FrancescaFr/MEMA/Pictures/DilutionTestChamber.JPG

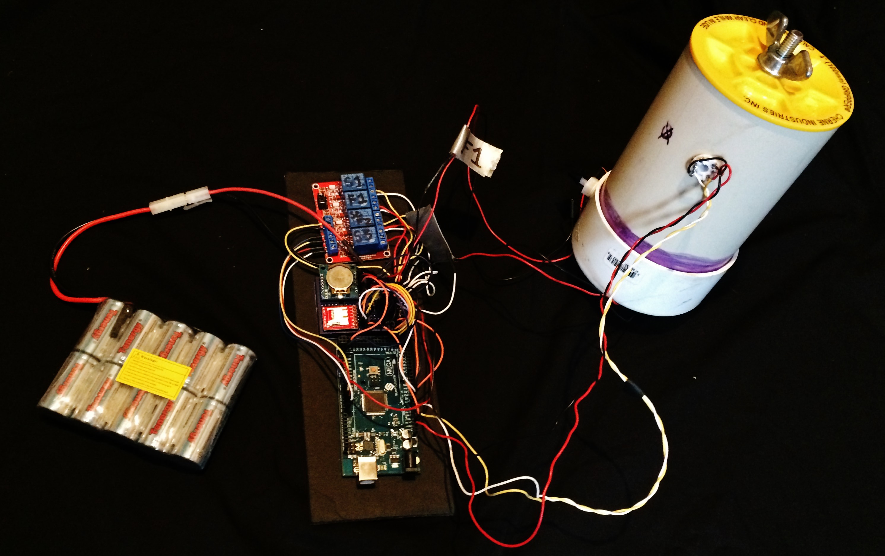
Pictures/DilutionTestChamber.JPG
