FrancescaFr/MEMA/Pictures/MEMA_V1.1_FieldTest.png

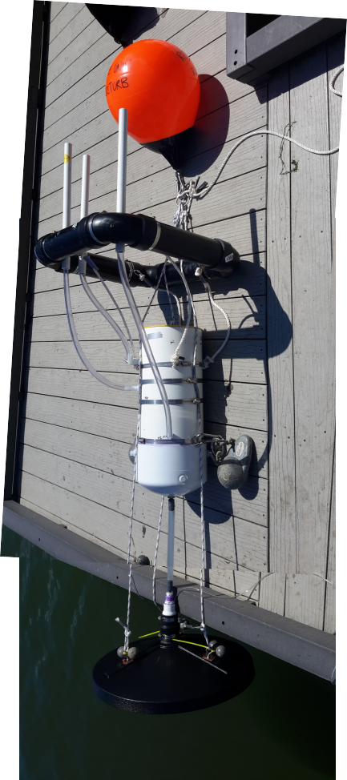
Pictures/MEMA_V1.1_FieldTest.png
