FrancescaFr/MEMA/Original_Project_Proposal.pdf

Low-cost, methane sensor for in-situ ebullition measurement

Context:
WSU Bio-geochemistry lab's methane ebullition study- an attempt to characterize methane emissions from Lacamas Reservoir, identifying spatial and temporal trends in methane ebullition and associated environmental and management factors.

Current data collection methods:
- Weather and management data -- provided by external sources (weather stations, reservoir management).
- Temperature and oxygen profiles – in-person, semi-weekly, water-column measurements.
- Dissolved methane, oxygen, and other nutrients – samples taken in conjunction with other water-column measurements and processed in-lab at a later date.
- Methane ebullition – array of ~15 methane traps distributed throughout Lacamas (active and passive) which collect bubbling methane for later extraction and in-lab processing.

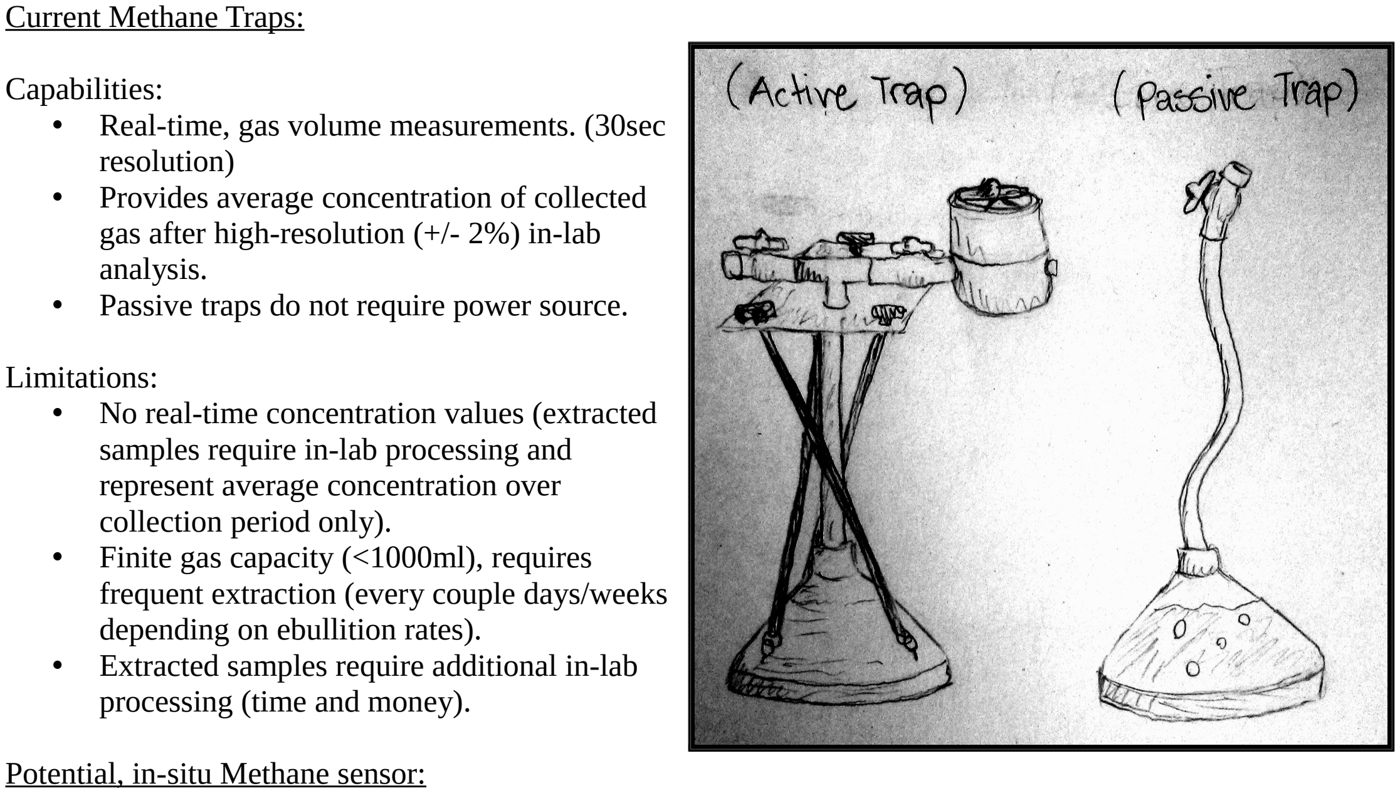
[picture p3: figure]
Current Methane Traps:; Capabilities:; resolution); analysis.; Limitations:; samples require in-lab processing and represent average concentration over collection period only).; frequent extraction (every couple days/weeks depending on ebullition rates).; processing (time and money).; Potential, in-situ Methane sensor:

- Real-time, gas volume measurements. (30sec
- Provides average concentration of collected gas after high-resolution (+/- 2%) in-lab
- Passive traps do not require power source.
- No real-time concentration values (extracted
- Finite gas capacity (<1000ml), requires
- Extracted samples require additional in-lab

Desired Capabilities:
- Real-time, gas volume and methane concentration measurements (more time-correlated data).
- Gas released after measurement (no capacity limitation, less frequent in-person maintenance).
- No in-lab analysis necessary (saves time).
- Affordable to replicate (maintain spatial resolution provided by current traps)

Anticipated Limitations:
- More electronically/mechanically complex (more points of failure).
- Less precise concentration measurements than samples processed in-lab.

Low-cost, methane sensor for in-situ ebullition measurement

Current design and constraints:

- Utilizes MQ4 Tin-oxide, solid-state methane sensor, RHT03 relative humidity and temperature sensor, and current active-trap pressure sensor.
- Requires continuous access to atmosphere for venting and accurate reading.
- Solid state sensors max out at 10% methane concentration, requiring dilution chamber.

Next steps:
Ideally, after compensating for humidity and temperature, the linear correlation between relative resistance and absolute concentration can be replicated and development can move onto construction of field chamber.

Current stage of development: Constructed test chamber. 'Burning-in sensors”, Testing methane sensor's precision, accuracy and behavior at various concentrations and under various humidity and temperature conditions and comparing to manufacturer's results.

4.19% | 6.64% | 10.52% | 16.67% | 26.41% | 41.86%

0.08

0.11

0.13

0.17

0.21

0.26

f(x) = 0.07 x^-0.41
R² = 0.97

MQ4(#3) Calibration Test 1
10mL dilluted injection

CH4 Concentration

Rs/R0

Technical Parameters of MQ-4 Sensor

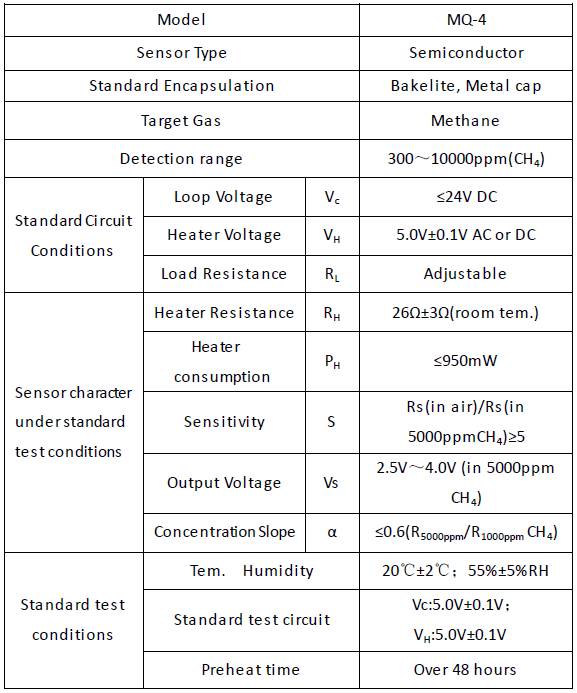
[picture p4: figure]
