FrancescaFr/MEMA/Diagrams/MEMA_DesignFigure.png

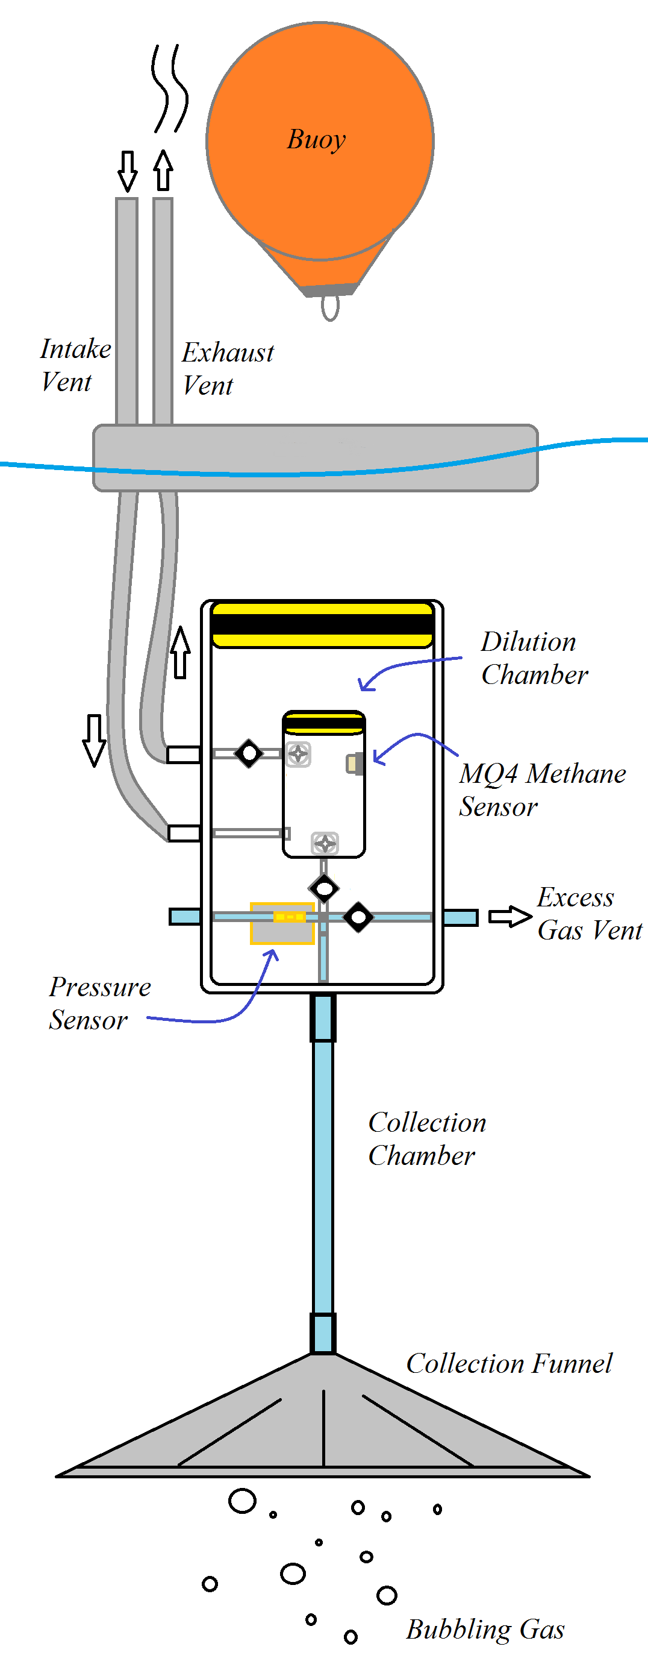
Diagrams/MEMA_DesignFigure.png
