FrancescaFr/MEMA/Diagrams/Original_Frame_Design.JPG

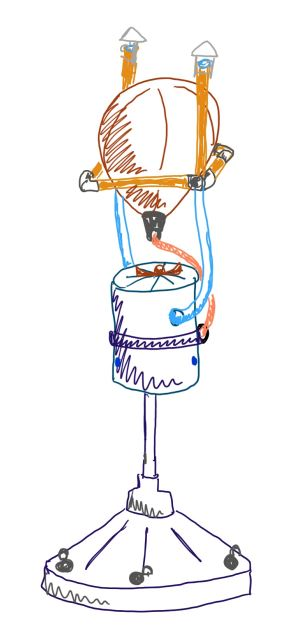
Diagrams/Original_Frame_Design.JPG
