FrancescaFr/MEMA/Diagrams/OriginalDesign1.1.JPG

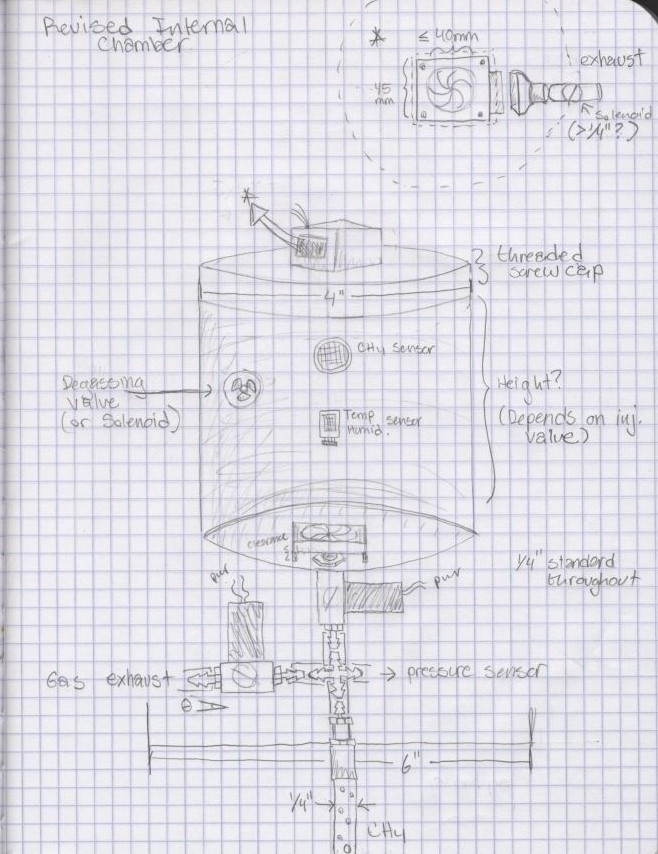
Diagrams/OriginalDesign1.1.JPG
