FrancescaFr/MEMA/Diagrams/OriginalDesign.JPG

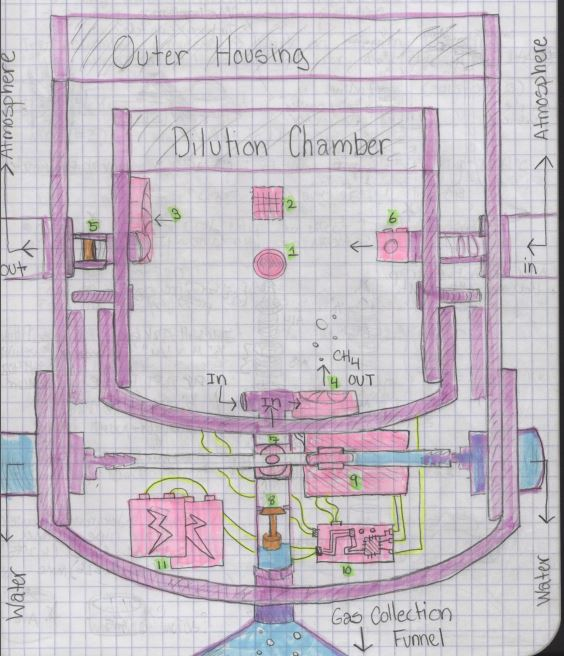
Diagrams/OriginalDesign.JPG
