FrancescaFr/MEMA/Diagrams/PinMap2560sma_.png

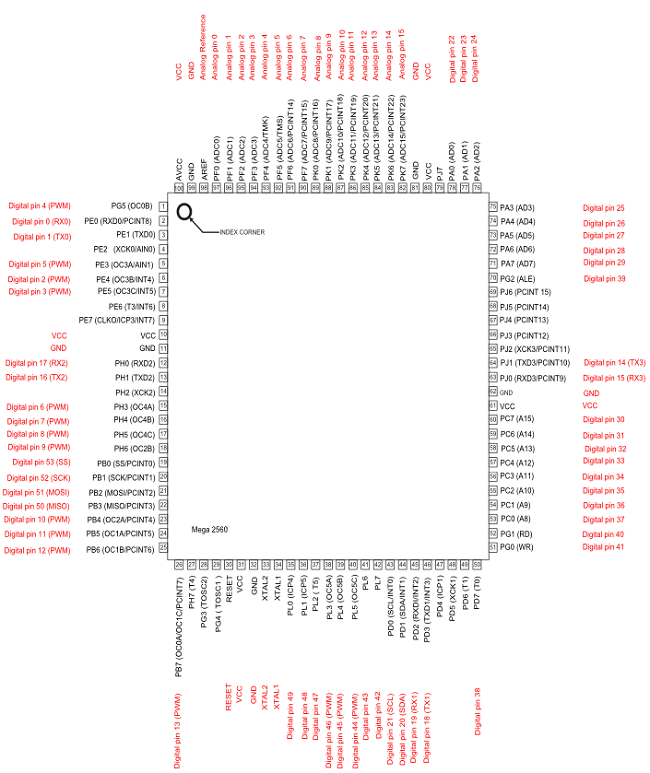
Diagrams/PinMap2560sma_.png
