FrancescaFr/MEMA/Diagrams/Pressure-transducer_hookup.JPG

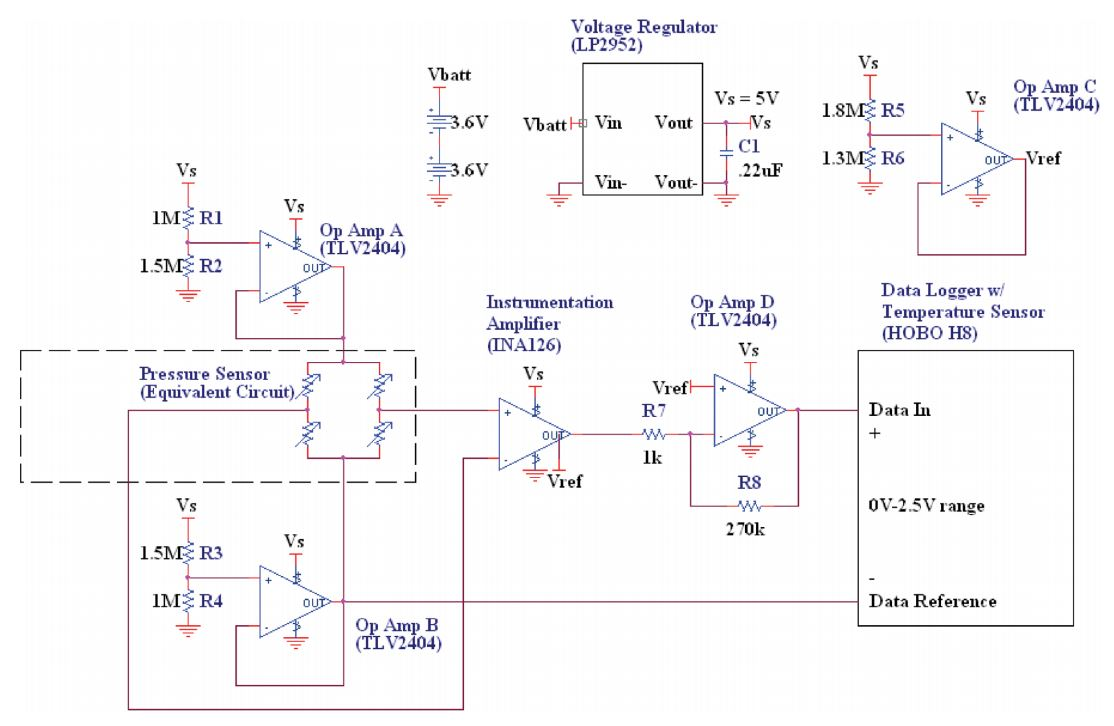
Diagrams/Pressure-transducer_hookup.JPG
