FrancescaFr/MEMA/Diagrams/RelayHookup.jpg

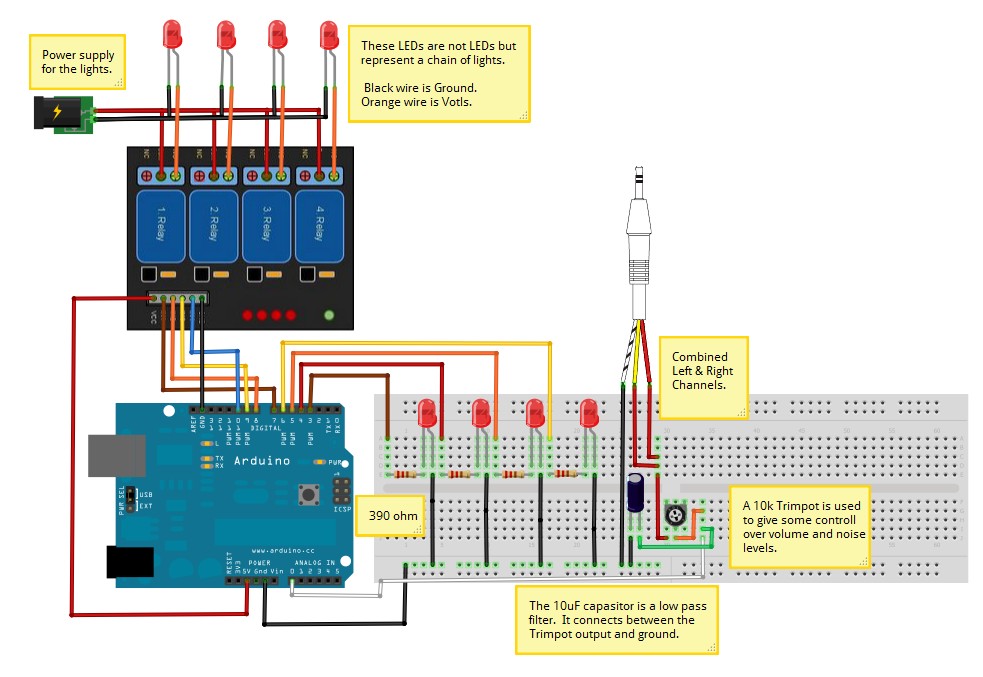
Diagrams/RelayHookup.jpg
