FrancescaFr/MEMA/Diagrams/SD_Board_HookupSchematic.png

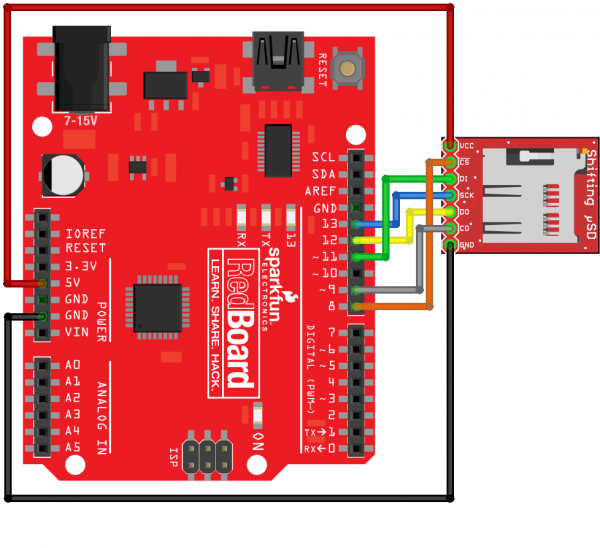
Diagrams/SD_Board_HookupSchematic.png
