FrancescaFr/MEMA/Pictures/FullMEMA_V2.0.jpg

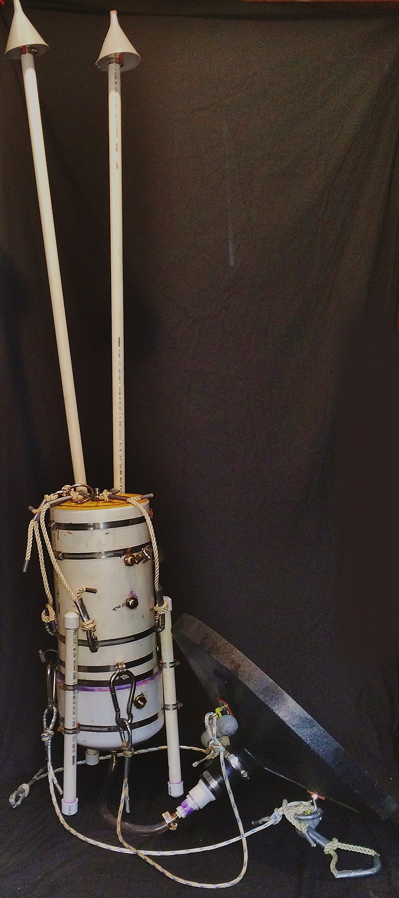
Pictures/FullMEMA_V2.0.jpg
