FrancescaFr/MEMA/Pictures/MEMA_V1.0_Prototype Sensor Outer Housing.jpeg

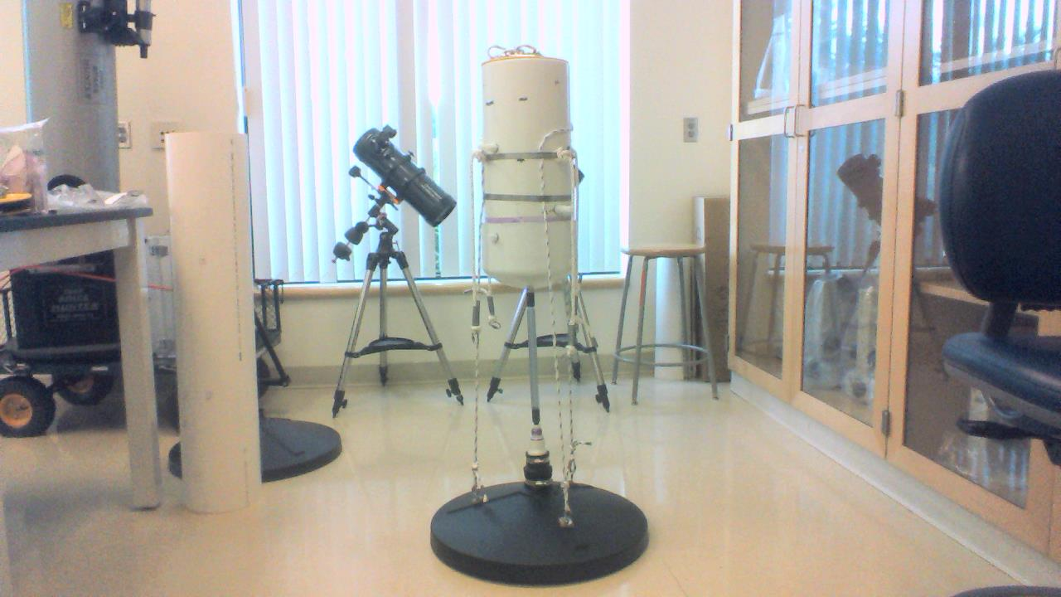
Pictures/MEMA_V1.0_Prototype Sensor Outer Housing.jpeg
