FrancescaFr/MEMA/Parts_BOM/MEMA_Parts_List.xlsx

MEMA 2.0 Comprehensive Parts List |  | Total Cost: | $823.07
HARDWARE
Assembly # | Detailed Description | Part | # in MEMA | Unit # | Unit Cost | Total Cost | Part # | Supplier | STL? | Link | Notes:
 | Standard-Wall White PVC Unthreaded Pipe, 8 Pipe Size x 5' Length | Outer Housing pipe | 2ft | 0.4 | $77.00 | $30.80 | 48925K26 | McMaster Carr
 | Drain White PVC Unthreaded Pipe Size 4 | Inner Housing | .5ft | 0.1 | $8.93 | $0.89 | 2426K25 | McMaster Carr
 | Wing Nut Expansion Plug for 7.70" to 8.03" Actual Pipe ID, Plastic | Outer wingnut plug | 1 | 1 | $43.06 | $43.06 | 2645K48 | McMaster Carr
 | Wing Nut Expansion Plug, Pipe Size 4 | Inner wingnut plug | 1 | 1 | $9.32 | $9.32 | 2645K44 | McMaster Carr
 | 1/2" ID, 5/8" OD PVC Tubing | 1/2" clear vent tubing | 5ft | 0.5 | $6.70 | $3.35 | 5231K371 | McMaster Carr
 | Worm-Drive Clamps for Firm Hose and Tube, Steel Screw, 9/16" Wide Band, 7-1/8" to 10" Clamp ID, packs of 5 | Large exterior mount zips | 6 | 1.2 | $9.27 | $11.12 | #5415K43 | McMaster Carr
 | Miniature Through-Wall Fitting High-Pressure Brass, 1/4 Pipe Size: | 1/2" brass throughwalls | 6 | 6 | $10.50 | $63.00 | #5415K43 | McMaster Carr
 | Standard-Wall White PVC Unthreaded Pipe, 3/4 Pipe Size x 5' Length: (x3) ea. @McMaster | Vent & leg structures | 11.5ft | 2.2 | $3.25 | $7.15 | #48925K92 | McMaster Carr
 | Standard-Wall White PVC Pipe Fitting 3/4 Pipe Size, Cap: | 3/4" PVC Endcaps | 6 | 6 | $0.32 | $1.92 | #4880K52 | McMaster Carr
 | Underground Sewer and Drain Pipe Fitting, 4 Trade Size, PVC Cap, Socket End | 4" PVC Endcap | 1 | 1 | $1.82 | $1.82 | 9102K224 | McMaster Carr
 | Standard-Wall White PVC Pipe Fitting, 8 Pipe Size, Cap | 8" PVC Endcap | 1 | 1 | $32.78 | $32.78 | 4880K142 | McMaster Carr
 | Worm-Drive Clamps for Firm Hose and Tube Steel Screw, 1/2" Band Width, 11/16" to 1-1/4" Clamp ID, pack of 10 | 1 1/4 " small exterior tube zips | 19 | 1.9 | $6.74 | $12.81 | #5415K14 | McMaster Carr
 | Brass Barbed Hose Fitting 1/2" Hose ID, 1/4 NPTF Male End pack of 5 | 1/2" brass nipples (straight) | 2 | 0.4 | $9.18 | $3.67 | #5346K22 | McMaster Carr
 | Brass Barbed Hose Elbow 90 Degree Angle, 1/2" Hose ID, 1/4 NPT Male End, Pack of 2 | 1/3" Brass nipples (elbow) | 3 | 1.5 | $8.28 | $12.42 | #53525K19 | McMaster Carr
 | Durable Nylon Extra-Grip Barbed Tube Fitting, Straight for 3/16" Tube ID x 1/4 Male Pipe Size | 3/16" Nylon barbed nipples | 5 | 0.5 | $3.97 | $1.99 | 5372K121 | McMaster Carr
 | Standard-Wall Brass Pipe Nipple Fully Threaded, 1/4 BSPT | 1/4" pipe Brass Threaded nipple | 3 | 3 | $3.29 | $9.87 | 4824K112 | McMaster Carr
 |  | 1/4" Brass nut | 1 |  | $0.50 | $0.00 |  | Hardware Store
 |  | 3/4" rope (ft) | 15 |  | $15.00 | $0.00 |  | Marine Store
 | Oval Shaped Threaded Connecting Link, Type 316 Stainless Steel, 1/8" Thickness, 3/16" Opening, Not for Lifting | Threaded connecting links | 3 | 3 | $1.97 | $5.91 | 8947T24 | McMaster Carr
 | Powder-Coated Steel Carabiner, 600 lbs. Capacity, 1/2" Narrow-End Inside Width | carabiners | 4 | 4 | $3.84 | $15.36 | 3079T44 | McMaster Carr |  |  | (Potentially find cheaper supplier/ different dimensions)
 | Cabela's Keel Downrigger Weights | 15lb weights | 3 | 3 | $67.99 | $203.97 | IK-010621 | Cabella |  | http://www.cabelas.com/product/Cabelas-Keel-Downrigger-Weights/733797.uts?productVariantId=1184309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 | (Potentially find cheaper supplier/ different dimensions)
 | Cabela's sinker | 8oz weights | 6 | 1 | $17.99 | $17.99 | IK-118098 | Cabella |  | http://www.cabelas.com/product/Cabelas-Cannonball-Sinkers-Unpainted/739412.uts?
 |  | Fisheye screws 3/16" | 3 | 3 | $0.50 | $1.50 |  | Hardware store
 |  | 3/16" nuts | 3 | 3 | $0.50 | $1.50 |  | Hardware store
 |  | 3/16" washers | 6 | 3 | $0.50 | $1.50 |  | Hardware store
 | TEXAS HUNTER LARGE FUNNEL FOR 55 GALLON BARREL DEER FEEDERS | Plastic collection funnell | 1 | 1 | $19.00 | $19.00 | LFBF | Texashunterproducts.com |  | http://www.texashunterproducts.com/texas-hunter-large-funnel-for-55-gallon-barrel-deer-feeders/
 |  | Metal fasters for legs (Copper wire, currently) | 6 | 2 | $3.50 | $7.00 |  | Hardware Store
 | Ring - Not for Lifting Steel, for 1/4 Chain Trade Size, 2" Inside Length | stainless steel 2" rings | 3 | 3 | $0.90 | $2.70 | 3564T26 | McMaster Carr
 | Durable nylon Tight-Seal Barbed tube fitting cross connector (10pk) | 3/16" tubing cross junction | 1 | 0.1 | $14.29 | $1.43 | 5463K95 | McMaster Carr
 | Low-Pressure Connector for Drain, Waste & Vent, Reducer, for 2 x 1-1/2 Pipe Size, 300 Series Stainless Steel Clamp | Flexable attachment (wormdrive clamp) | 1 | 1 | $4.98 | $4.98 | 4511K74 | McMaster Carr
 | Thick-Wall Dark Gray PVC Thread-One-End Pipe Nipple 1/4 Pipe Size | 1/4" screw/pipe nipple PVC | 2 | 2 | $1.76 | $3.52 | 9173K31 | McMaster Carr
 | Medium-Pressure Brass Threaded Pipe Fitting 1/4 Pipe Size, Hollow Hex-Head Plug | Brass Plug | 1 | 1 | $1.27 | $1.27 | #50785K22 | McMaster Carr
 |  | 1/2" to 3/16" check valve | 1 |  |  | $0.00
 | Chemical-Resistant Type I PVC Sheet, 1/8" Thick, 12" x 12" | Funnel Padding | 6in^2 | 0.2 | $5.66 | $1.13 | #8747K112 | McMaster Carr
 | Standard-Wall White PVC Pipe Fitting, 1-1/4 x 1 Pipe Size, Reducing Coupling | Funnell Connector | 1 | 1 | $1.44 | $1.44 | 4880K683 | McMaster Carr
 | Standard-Wall White PVC Pipe Fitting, 1 x 3/4 Pipe Size, Reducing Coupling | Funnell Connector | 1 | 1 | $0.86 | $0.86 | 4880K682 | McMaster Carr
 | Standard-Wall White PVC Pipe Fitting, 3/4 x 1/2 Pipe Size, Reducing Coupling | Funnell Connector | 1 | 1 | $0.50 | $0.50 | 4880K681 | McMaster Carr
 | Standard-Wall White PVC Pipe Fitting, 1/2 Pipe End Male x 1/4 NPT Female, Hex Bushing | Funnell Connector | 1 | 1 | $0.67 | $0.67 | 4880K199 | McMaster Carr
 | Multipurpose Oil-resistant O-rings ID 5/8” Width 1/16” 100pk | O-Rings | 6 | 0.1 | $3.12 | $0.31 | 9452K6
 | 1/4" Electric Solenoid Valve 12-volt Air, Water | 12v Solenoid valved | 3 | 3 | $11.99 | $35.97 | JFSV00005 | U.S. Solid
 | 4 Channel 12V Low Level Trigger Relay Module for (For Arduino) (Works with Official (For Arduino) Boards) | 12v relay board | 1 | 1 | $5.99 | $5.99 | #00903435 | miniinthebox |  | http://www.miniinthebox.com/4-channel-12v-low-level-trigger-relay-module-for-arduino-works-with-official-arduino-boards_p903435.html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 | (potentially find cheaper supplier / different specifications)
 |  | Presure Circuit + PWR supply (?) | 1 | 1 | $30.00 |  |  | (Estimate)
 | PX26-005DV Pressure Transducer | Pressure transducer (+Circuit and PWR supply) | 1 | 1 | $45.00 | $45.00 | PX26-005DV | omega.com
 | MQ4 Methane Sensor | MQ4 | 1 | 1 | $4.95 | $4.95 | SEN-09404 RoHS | Sparkfun
 |  | MQ4 sensor port | 1 |  |  | $0.00
 | Blowers 40x40x10mm 12V DC Fan | Centrifugal fan, 12v | 1 | 1 | $12.31 | $12.31 | 108-BFB0412HHA-A | Mouser
 | Sunon Fan; DC; 12V; 35x35x10mm; Sq; 7CFM; 0.72W; 28dBA; 9500RPM | axial fan, 12v | 1 | 1 | $8.78 | $8.78 | 70226237 | Allied Electronics
 | Raspberry Pi Zero | Controller (Arduino,clock,sd or Pi zero)(?) | 1 | 1 | $5.00 | $5.00 | PI-ZERO-1V3 | Canakit.com
 | AT: Tenergy NiMH 12V 4200mAh Side by Side Rechargeable Battery Pack (10S1P, 50.4Wh, 30A Rate, Standard Tamiya Connector) | PWR supply 12v(?) | 2 | 2 | $64.99 | $129.98 | 11616 | All-battery.com
 | Tenergy Smart Universal Charger for NiMH/NiCD Battery Packs: 6v - 12v | 12v Charger | 1 | 1 | $22.99 | $22.99 | #01025 | All-battery.com
 |  | PWR supply 5v (?) | 1 |  |  | $0.00
 |  | Wire (misc.) | 1 |  |  | $0.00
 |  | Breadboard(?) | 1 | 1 | $3.00 | $3.00
 |  | Velcro (ft) | 1 |  |  | $0.00
 |  | foam support pads | 4 |  |  | $0.00
 | Tubing | Tygon PVC Clear Tubing, 3/16" ID, 1/4" OD | 3 | 3 | $0.55 | $1.65 | 6516T17 | McMaster Carr
 | Drinking Water Push-to-Connect Tube Fitting | Push-to-connect Cross fitting | 1 | 1 | $8.94 | $8.94 | 51055K432 | McMaster Carr
 |  |  |  |  |  | Total Cost | Cost above Goal
 |  |  |  |  |  | $823.07 | $323.07
