FrancescaFr/MEMA/Parts_BOM/Parts to Replace and Update sensor.xlsx

Parts to be replaced/repaired: | Quantity | PPU | Total | ID | Supplier
MQ4 Sensor | 2 | $4.95 | $9.90 | SEN-09404 RoHS | Sparkfun
Tiny RTC | 1 | $5.99 | $5.99 | B00UUR8GJU | Amazon
Pressure Sensor: Erratic Readings-Replace battery pack/check wiring (parts at lab) | 1 |  | $0.00
New Parts: |  |  | $0.00
Miniature Through-Wall Fitting High-Pressure Brass, 1/4 Pipe Size: | 6 | $10.50 | $63.00 | #8682T22 | McMaster
Brass Barbed Hose Fitting 1/2" Hose ID, 1/4 NPTF Male End pack of 5 | 1 | $9.18 | $9.18 | #5346K22 | McMaster
Brass Barbed Hose Elbow 90 Degree Angle, 1/2" Hose ID, 1/4 NPT Male End, Pack of 2 | 2 | $8.28 | $16.56 | #53525K19 | McMaster
Medium-Pressure Brass Threaded Pipe Fitting 1/4 Pipe Size, Hollow Hex-Head Plug | 1 | $1.27 | $1.27 | #50785K22 | McMaster
Trade-Sized Abrasion-Resistant Plug Size 00, Fits 19/32" Large End ID, pack of 50 | 1 | $6.67 | $6.67 | #9545K113 | McMaster
High Strength Cable Tie Nylon, 8" Long, 2" Bundle Diameter, 400 lb. Break Strength, pack of 10 | 1 | $6.25 | $6.25 | #7177K61 | McMaster
Standard-Wall White PVC Unthreaded Pipe, 3/4 Pipe Size x 5' Length: (x3) ea. @McMaster | 3 | $3.25 | $9.75 | #48925K92 | McMaster
Worm-Drive Clamps for Firm Hose and Tube, Steel Screw, 9/16" Wide Band, 7-1/8" to 10" Clamp ID, packs of 5 | 1 | $9.27 | $9.27 | #5415K43 | McMaster
Standard-Wall White PVC Pipe Fitting 3/4 Pipe Size, Cap: | 6 | $0.32 | $1.92 | #4880K52 | McMaster
Worm-Drive Clamps for Firm Hose and Tube Steel Screw, 1/2" Band Width, 11/16" to 1-1/4" Clamp ID, pack of 10 | 1 | $6.74 | $6.74 | #5415K14 | McMaster
1/2" ID PVC Tubing | 15 | $0.60 | $9.00 |  | HardwareSt.
3/16" nuts and bolts | 3 |  | $0.00 |  | Have
 | Grand Total: |  | $155.50
