FrancescaFr/MEMA/Tests_Data/Error_Calculations.xlsx

Error Calculations: |  |  | Inj. Test | Repeatability CH4 | MQ4 Calib
Intermediary Values | Symbol | Function |  |  |  |  | solenoid uncertainty
Mean Value | x | Average(Data) | 2.9166 | 0.1835 |  |  | 8.9 | mm cubed | 0.0089 | ml
Sample SD | s | STDeV(Data) | 1.977 | 0.0092 |  |  |  | error | 0.00178
Sample Size | n | Count(Data) | 9 | 9
Std. Uncertainty | u | s/sqrit(n) | 0.659 | 0.003066666667
Degrees of Freedom | df | n-1 | 8 | 8
T-value | t | TINV(0.05,df) | 2.306004135 | 2.306004135
95% Confidence Dev. | Cd | t*s/sqrt(n) | 1.519656725 | 0.007500719343
95% Confidence Int. | CI | x +/- Cd | 4.436256725 | 0.04087585473
Error Sources: |  |  |  | Error Source Summary
Random Error: (Constant) |  |  |  |  |  | CH4 Concentration Error (Diluted): |  |  | Gas Volume Error: (Undiluted)
Pressure Sensor Noise | 0.65ml |  |  |  |  | MQ4 Sensor Noise (95% Conf. Int.) |  | 4% | Pressure Sensor Resolution |  | +/- 0.21 ml
MQ4 Sensor Noise | --------- |  |  |  |  | MQ4 Measurement Resolution |  | 0.56% | Pressure Sensor Noise |  | 0.21ml
 |  |  |  |  |  | Solenoid Injection Uncertainty |  | 0.18% | Pressure Model Uncertainty (95% Conf. Int.) |  | 1.2%
Measurement Error: (Constant) |  |  |  |  |  | Calibration Curve Error (95% Conf. Int.) |  | 1.10%
Pressure Resolution | 0.21ml |  |  |  |  | Total Concentration Error (RMS):
MQ4 Resolution | 0.56%
Calbration Error: (Scales w/ Input)
Pressure Curve | 1%
MQ4 Curve | 1.10%
Total Error:
Volume | 0.68ml +/- 1%*Val
CH4 Concentration | 0.56% +/- 1.1%*Val
Sample Error Calc: | 5ml inj. from 40ml of 50% CH4 gas
CH4 Conc. Error: |  | +/-1.11%
Gas Volume Error: |  | +/- 1.08 ml
CH4 Total Error by Volume |  | +/- 0.60 ml
CH4 Total Error by Percent |  | +/- 3%
