FrancescaFr/MEMA/Tests_Data/RAW_Data/Full Program Test Run.txt

Initializing SD card...card initialized.
DS1307 read error!  Please check the circuitry.

V: 1.79, P: 0.43, 
DS1307 read error!  Please check the circuitry.

V: 1.79, P: 0.39, 
DS1307 read error!  Please check the circuitry.

V: 1.80, P: 0.45, 
V: 1.79, P: 0.46,  Time: 8:33:26 Date: 9/8/2016
V: 1.79, P: 0.43,  Time: 8:33:27 Date: 9/8/2016
V: 1.79, P: 0.43,  Time: 8:33:28 Date: 9/8/2016
V: 1.78, P: 0.43,  Time: 8:33:29 Date: 9/8/2016
V: 1.79, P: 0.43,  Time: 8:33:30 Date: 9/8/2016
V: 1.79, P: 0.43,  Time: 8:33:31 Date: 9/8/2016
V: 1.79, P: 0.45,  Time: 8:33:32 Date: 9/8/2016
V: 1.79, P: 0.44,  Time: 8:33:33 Date: 9/8/2016
V: 1.79, P: 0.44,  Time: 8:33:34 Date: 9/8/2016
V: 1.78, P: 0.43,  Time: 8:33:35 Date: 9/8/2016
V: 1.79, P: 0.45,  Time: 8:33:36 Date: 9/8/2016
V: 1.79, P: 0.47,  Time: 8:33:37 Date: 9/8/2016
V: 1.78, P: 0.45,  Time: 8:33:38 Date: 9/8/2016
V: 1.78, P: 0.43,  Time: 8:33:39 Date: 9/8/2016
V: 1.78, P: 0.46,  Time: 8:33:40 Date: 9/8/2016
V: 1.79, P: 0.44,  Time: 8:33:41 Date: 9/8/2016
V: 1.78, P: 0.44,  Time: 8:33:42 Date: 9/8/2016
V: 1.78, P: 0.47,  Time: 8:33:43 Date: 9/8/2016
V: 1.78, P: 0.43,  Time: 8:33:44 Date: 9/8/2016
V: 1.78, P: 0.44,  Time: 8:33:45 Date: 9/8/2016
V: 1.78, P: 0.44,  Time: 8:33:46 Date: 9/8/2016
V: 1.78, P: 0.44,  Time: 8:33:47 Date: 9/8/2016
V: 1.79, P: 0.45,  Time: 8:33:48 Date: 9/8/2016
V: 1.78, P: 0.42,  Time: 8:33:49 Date: 9/8/2016
V: 1.78, P: 0.43,  Time: 8:33:50 Date: 9/8/2016
V: 1.78, P: 0.44,  Time: 8:33:51 Date: 9/8/2016
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
V: 1.06, P: 0.40,  Time: 8:47:55 Date: 9/8/2016
V: 1.06, P: 0.41,  Time: 8:47:56 Date: 9/8/2016
V: 1.06, P: 0.40,  Time: 8:47:57 Date: 9/8/2016
V: 1.05, P: 0.39,  Time: 8:47:58 Date: 9/8/2016
V: 1.06, P: 0.40,  Time: 8:47:59 Date: 9/8/2016
V: 1.06, P: 0.40,  Time: 8:48:0 Date: 9/8/2016
