FrancescaFr/MEMA/Tests_Data/RAW_Data/Test data right before leaving lab to deployment 2016-08-10.txt

Initializing SD card...card initialized.
V: 2.07, P: 0.25, Time: 64
V: 2.07, P: 0.26, Time: 65
V: 2.07, P: 0.25, Time: 66
V: 2.07, P: 0.25, Time: 67
V: 2.06, P: 0.24, Time: 68
V: 2.06, P: 0.25, Time: 69
V: 2.06, P: 0.25, Time: 70
V: 2.06, P: 0.25, Time: 71
V: 2.06, P: 0.25, Time: 72
V: 2.06, P: 0.24, Time: 73
V: 2.06, P: 0.26, Time: 74
V: 2.06, P: 0.26, Time: 75
V: 2.06, P: 0.25, Time: 76
V: 2.06, P: 0.25, Time: 77
V: 2.06, P: 0.26, Time: 78
V: 2.06, P: 0.25, Time: 79
V: 2.06, P: 0.25, Time: 80
V: 2.06, P: 0.25, Time: 81
V: 2.06, P: 0.25, Time: 82
V: 2.06, P: 0.25, Time: 83
V: 2.06, P: 0.24, Time: 84
V: 2.06, P: 0.25, Time: 85
V: 2.06, P: 0.26, Time: 86
V: 2.06, P: 0.25, Time: 87
V: 2.06, P: 0.25, Time: 88
V: 2.06, P: 0.25, Time: 89
V: 2.06, P: 0.25, Time: 90
V: 2.06, P: 0.25, Time: 91
V: 2.06, P: 0.24, Time: 92
V: 2.06, P: 0.25, Time: 93
V: 2.06, P: 0.25, Time: 94
V: 2.06, P: 0.25, Time: 95
V: 2.07, P: 0.24, Time: 96
V: 2.07, P: 0.25, Time: 97
V: 2.07, P: 0.25, Time: 98
V: 2.07, P: 0.25, Time: 99
V: 2.06, P: 0.25, Time: 100
V: 2.07, P: 0.25, Time: 101
V: 2.07, P: 0.25, Time: 102
V: 2.07, P: 0.25, Time: 103
V: 2.07, P: 0.25, Time: 104
V: 2.07, P: 0.24, Time: 105
V: 2.07, P: 0.26, Time: 106
V: 2.07, P: 0.25, Time: 107
V: 2.07, P: 0.25, Time: 108
V: 2.07, P: 0.25, Time: 109
V: 2.07, P: 0.25, Time: 110
V: 2.07, P: 0.25, Time: 111
V: 2.07, P: 0.25, Time: 112
V: 2.07, P: 0.25, Time: 113
V: 2.07, P: 0.25, Time: 114
V: 2.07, P: 0.25, Time: 115
V: 2.07, P: 0.25, Time: 116
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
V: 1.29, P: 0.25, Time: 1108
V: 1.29, P: 0.24, Time: 1109
V: 1.29, P: 0.25, Time: 1110
V: 1.29, P: 0.25, Time: 1111
V: 1.29, P: 0.25, Time: 1112
V: 1.30, P: 0.25, Time: 1113
V: 1.30, P: 0.26, Time: 1114
V: 1.30, P: 0.26, Time: 1115
V: 1.30, P: 0.26, Time: 1116
V: 1.30, P: 0.26, Time: 1117
