FrancescaFr/MEMA/Tests_Data/Methane_5ml_Repeatability_Test.xlsm

V: | 0.75 | Time: | 11:27:2 | Date: | 6/6/2017
V: | 0.75 | Time: | 11:27:3 | Date: | 6/6/2017
V: | 0.75 | Time: | 11:27:4 | Date: | 6/6/2017
V: | 0.74 | Time: | 11:27:5 | Date: | 6/6/2017
V: | 0.75 | Time: | 11:27:6 | Date: | 6/6/2017
V: | 0.74 | Time: | 11:27:7 | Date: | 6/6/2017
V: | 0.74 | Time: | 11:27:8 | Date: | 6/6/2017
V: | 0.74 | Time: | 11:27:9 | Date: | 6/6/2017
V: | 0.74 | Time: | 11:27:10 | Date: | 6/6/2017
V: | 0.74 | Time: | 11:27:11 | Date: | 6/6/2017
V: | 0.74 | Time: | 11:27:12 | Date: | 6/6/2017
V: | 0.74 | Time: | 11:27:13 | Date: | 6/6/2017
V: | 0.74 | Time: | 11:27:14 | Date: | 6/6/2017
V: | 0.74 | Time: | 11:27:15 | Date: | 6/6/2017
V: | 0.74 | Time: | 11:27:16 | Date: | 6/6/2017
V: | 0.74 | Time: | 11:27:18 | Date: | 6/6/2017
V: | 0.74 | Time: | 11:27:19 | Date: | 6/6/2017
V: | 0.75 | Time: | 11:27:20 | Date: | 6/6/2017
V: | 0.74 | Time: | 11:27:21 | Date: | 6/6/2017
V: | 0.74 | Time: | 11:27:22 | Date: | 6/6/2017
V: | 0.74 | Time: | 11:27:23 | Date: | 6/6/2017
V: | 0.74 | Time: | 11:27:24 | Date: | 6/6/2017
V: | 0.75 | Time: | 11:27:25 | Date: | 6/6/2017
V: | 0.74 | Time: | 11:27:26 | Date: | 6/6/2017
V: | 0.74 | Time: | 11:27:27 | Date: | 6/6/2017
V: | 0.74 | Time: | 11:27:28 | Date: | 6/6/2017
V: | 0.74 | Time: | 11:27:29 | Date: | 6/6/2017
V: | 0.73 | Time: | 11:27:30 | Date: | 6/6/2017
V: | 0.74 | Time: | 11:27:31 | Date: | 6/6/2017
V: | 0.74 | Time: | 11:27:32 | Date: | 6/6/2017
V: | 0.74 | Time: | 11:27:33 | Date: | 6/6/2017
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
V: | 2.33 | Time: | 12:9:15 | Date: | 6/6/2017
V: | 2.33 | Time: | 12:9:16 | Date: | 6/6/2017
V: | 2.33 | Time: | 12:9:17 | Date: | 6/6/2017
V: | 2.33 | Time: | 12:9:18 | Date: | 6/6/2017
V: | 2.33 | Time: | 12:9:19 | Date: | 6/6/2017
V: | 2.33 | Time: | 12:9:20 | Date: | 6/6/2017
V: | 2.33 | Time: | 12:9:21 | Date: | 6/6/2017
V: | 2.33 | Time: | 12:9:22 | Date: | 6/6/2017
V: | 2.33 | Time: | 12:9:23 | Date: | 6/6/2017
V: | 2.32 | Time: | 12:9:24 | Date: | 6/6/2017
V: | 2.32 | Time: | 12:9:25 | Date: | 6/6/2017
V: | 2.32 | Time: | 12:9:26 | Date: | 6/6/2017
V: | 2.32 | Time: | 12:9:27 | Date: | 6/6/2017
V: | 2.32 | Time: | 12:9:28 | Date: | 6/6/2017
V: | 2.32 | Time: | 12:9:29 | Date: | 6/6/2017
V: | 2.32 | Time: | 12:9:30 | Date: | 6/6/2017
V: | 2.32 | Time: | 12:9:31 | Date: | 6/6/2017
V: | 2.31 | Time: | 12:9:32 | Date: | 6/6/2017
V: | 2.32 | Time: | 12:9:33 | Date: | 6/6/2017
V: | 2.32 | Time: | 12:9:34 | Date: | 6/6/2017
V: | 2.31 | Time: | 12:9:35 | Date: | 6/6/2017
V: | 2.25 | Time: | 12:9:36 | Date: | 6/6/2017
V: | 2.17 | Time: | 12:9:37 | Date: | 6/6/2017
V: | 2.10 | Time: | 12:9:38 | Date: | 6/6/2017
V: | 2.03 | Time: | 12:9:39 | Date: | 6/6/2017
V: | 1.94 | Time: | 12:9:40 | Date: | 6/6/2017
V: | 1.85 | Time: | 12:9:41 | Date: | 6/6/2017
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
