FrancescaFr/MEMA/Tests_Data/MQ4_Initial_Burn-in_Testing.ods

Sheet: Initial_Test
MQ4 Test #, Sensor #3, 2015-09-24, 10mL diluted injection into test housing
Injection | Concentration | Base Voltage | Peak Voltage | Rs/R0 | Variable:
1 | 5.00% | 1.1926 | 2.8299 | 0.240201081 | Input Voltage: | 5
2 | 5.00% | 1.1241 | 2.7908 | 0.22958246 | Const.(Ω): | 10000
3 | 10.00% | 1.085 | 3.0401 | 0.178666864 | Max a. value | 1023
4 | 10.00% | 1.002 | 3.0156 | 0.164922692 | Resistance Equation:
5 | 20.00% | 0.9433 | 3.2942 | 0.12040793 | MQ4(Ω) = (10000Ω*(Vin-Vout))/Vout
6 | 20.00% | 0.8944 | 3.2845 | 0.113782799
7 | 30.00% | 0.9042 | 3.3675 | 0.107021577 | Correlative Function:
8 | 30.00% | 0.9091 | 3.3724 | 0.107251011
9 | 40.00% | 0.9091 | 3.4995 | 0.095284618
10 | 40.00% | 0.9091 | 3.4995 | 0.095284618
11 | 50.00% | 0.9482 | 3.5093 | 0.099408085
12 | 50.00% | 0.9286 | 3.5386 | 0.094193848
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
