FrancescaFr/MEMA/Tests_Data/Pressure_Sensor_Calibration_2016-08-07.xlsx

Sheet: Dry Baseline
Pressure sensor #11 Dry, zero-pressure, baseline reading (632 data points)
Voltage: | Average: | SD: | CV
 | 0.3297933227 | 0.02667215824 | 8.087537377
0.32
0.32
0.33
0.29
0.33
0.32
0.31
0.3
0.34
0.3
0.3
0.34
0.25
0.27
0.28
0.25
0.29
0.32
0.29
0.26
0.25
0.29
0.29
0.28
0.28
0.29
0.27
0.26
0.28
0.26
0.26
0.34
0.29
0.32
0.31
0.31
0.31
0.32
0.36
0.36
0.31
0.31
0.32
0.31
0.3
0.32
0.31
0.32
0.31
0.31
0.34
0.32
0.3
0.3
0.33
0.31
0.32
0.35
0.3
0.31
0.34
0.3
0.3
0.34
0.31
0.31
0.34
0.33
0.3
0.31
0.33
0.3
0.3
0.34
0.32
0.31
0.35
0.31
0.34
0.33
0.31
0.35
0.32
0.33
0.37
0.26
0.26
0.35
0.32
0.34
0.31
0.35
0.33
0.34
0.33
0.33
0.31
0.33
0.31
0.34
0.36
0.3
0.28
0.32
0.34
0.32
0.32
0.32
0.34
0.32
0.33
0.33
0.32
0.31
0.32
0.33
0.37
0.33
0.33
0.33
0.32
0.31
0.32
0.31
0.34
0.32
0.33
0.32
0.35
0.33
0.33
0.35
0.33
0.34
0.3
0.33
0.32
0.33
0.33
0.33
0.33
0.32
0.35
0.33
0.35
0.34
0.32
0.34
0.34
0.33
0.32
0.33
0.33
0.33
0.33
0.35
0.34
0.34
0.32
0.35
0.32
0.34
0.32
0.34
0.32
0.33
0.32
0.3
0.31
0.33
0.33
0.33
0.35
0.33
0.35
0.33
0.35
0.32
0.3
0.28
0.28
0.27
0.3
0.27
0.26
0.27
0.32
0.33
0.33
0.33
0.32
0.32
0.33
0.32
0.38
0.34
0.36
0.33
0.37
0.34
0.36
0.33
0.34
0.34
0.34
0.32
0.36
0.33
0.34
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
