FrancescaFr/MEMA/Tests_Data/VentTimeGraph.xlsx

Seconds | Time | Voltage
3 | 13:30:17 | 1.38 | 0.78 | 0.05
4 | 13:30:18 | 1.38 | 0.78 | 0.06666666667
5 | 13:30:19 | 1.38 | 0.78 | 0.08333333333
6 | 13:30:20 | 1.38 | 0.78 | 0.1
7 | 13:30:21 | 1.38 | 0.78 | 0.1166666667
8 | 13:30:22 | 1.38 | 0.78 | 0.1333333333
9 | 13:30:23 | 1.38 | 0.78 | 0.15
10 | 13:30:24 | 1.38 | 0.78 | 0.1666666667
11 | 13:30:25 | 1.38 | 0.78 | 0.1833333333
12 | 13:30:26 | 1.38 | 0.78 | 0.2
13 | 13:30:27 | 1.38 | 0.78 | 0.2166666667
14 | 13:30:28 | 1.38 | 0.78 | 0.2333333333
15 | 13:30:29 | 1.38 | 0.78 | 0.25
16 | 13:30:30 | 1.38 | 0.78 | 0.2666666667
17 | 13:30:31 | 1.38 | 0.78 | 0.2833333333
18 | 13:30:32 | 1.38 | 0.78 | 0.3
19 | 13:30:33 | 1.38 | 0.78 | 0.3166666667
20 | 13:30:34 | 1.38 | 0.78 | 0.3333333333
21 | 13:30:35 | 1.38 | 0.78 | 0.35
22 | 13:30:36 | 1.38 | 0.78 | 0.3666666667
23 | 13:30:37 | 1.38 | 0.78 | 0.3833333333
24 | 13:30:38 | 1.38 | 0.78 | 0.4
25 | 13:30:39 | 1.38 | 0.78 | 0.4166666667
26 | 13:30:40 | 1.38 | 0.78 | 0.4333333333
27 | 13:30:41 | 1.38 | 0.78 | 0.45
28 | 13:30:42 | 1.38 | 0.78 | 0.4666666667
29 | 13:30:43 | 1.38 | 0.78 | 0.4833333333
30 | 13:30:44 | 1.38 | 0.78 | 0.5
31 | 13:30:45 | 1.38 | 0.78 | 0.5166666667
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
