FrancescaFr/MEMA/Tests_Data/MATLAB_MQ4_CurveFit1.jpg

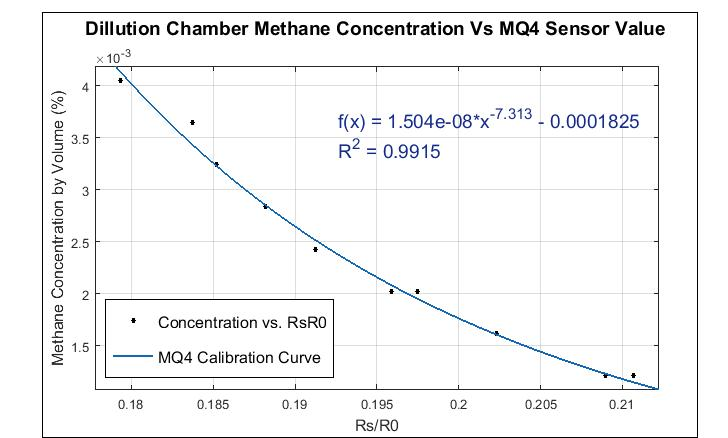
Tests_Data/MATLAB_MQ4_CurveFit1.jpg
