FrancescaFr/MEMA/Tests_Data/MQ4_Drift.PNG

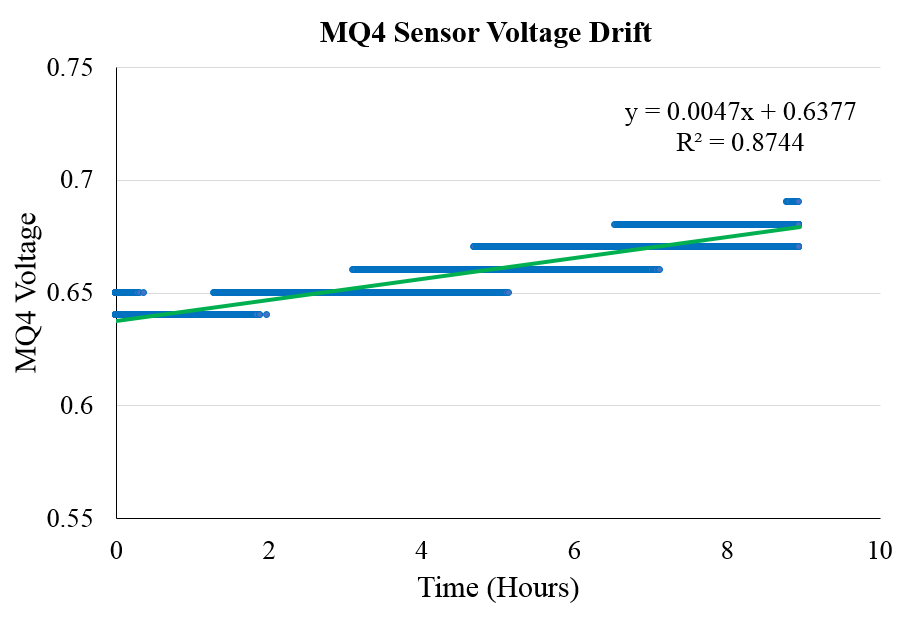
Tests_Data/MQ4_Drift.PNG
