FrancescaFr/MEMA/Tests_Data/MQ4_Sensor_Interpretation.PNG

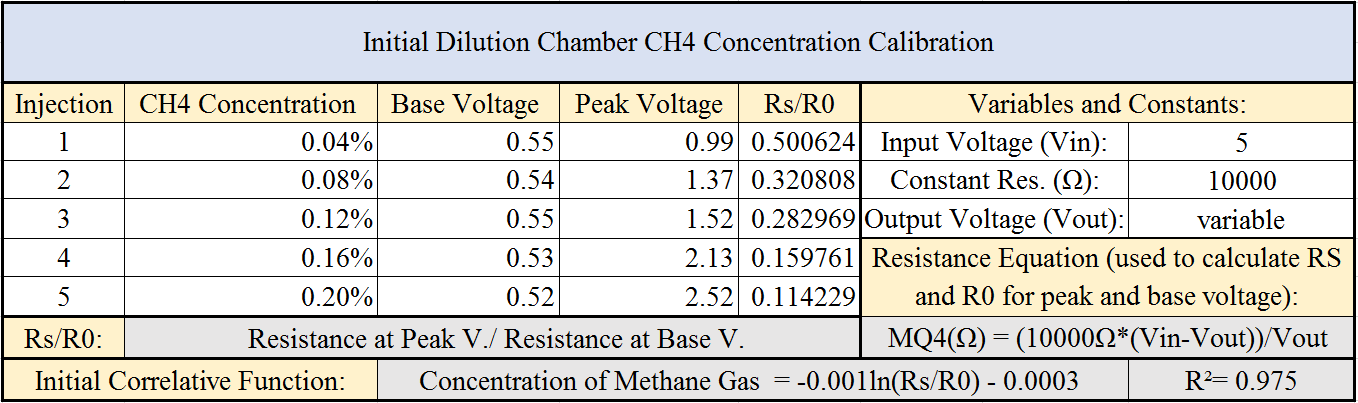
Tests_Data/MQ4_Sensor_Interpretation.PNG
