FrancescaFr/MEMA/Tests_Data/MQ4Repeatability.JPG

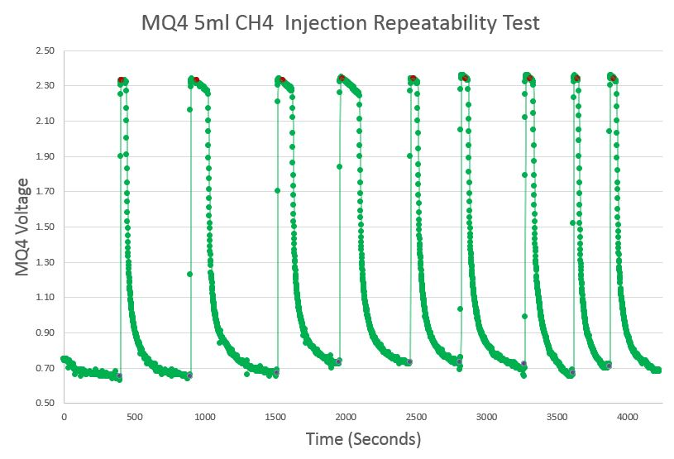
Tests_Data/MQ4Repeatability.JPG
