FrancescaFr/MEMA/Tests_Data/Pressure_Functions.JPG

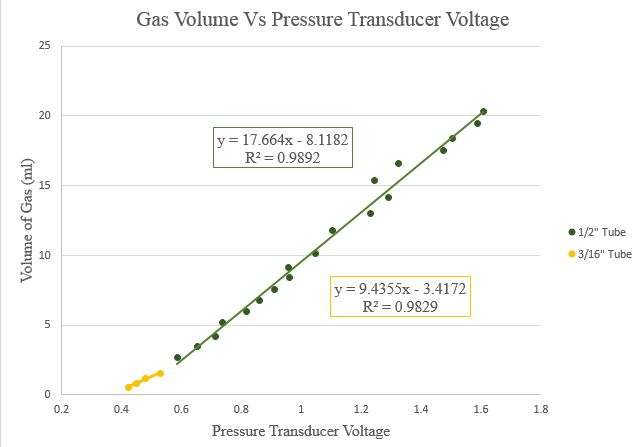
Tests_Data/Pressure_Functions.JPG
