FrancescaFr/MEMA/Tests_Data/Pressure_Results_Field_Test_1.PNG

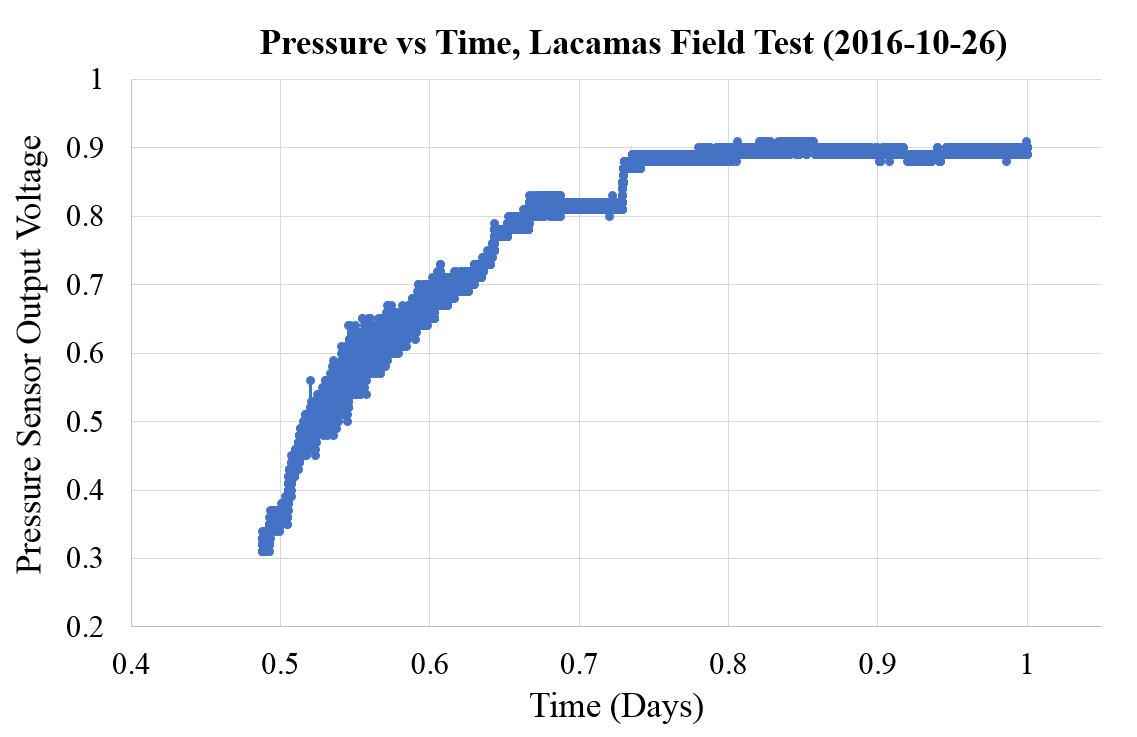
Tests_Data/Pressure_Results_Field_Test_1.PNG
