FrancescaFr/MEMA/Tests_Data/Water_Height_vs_Voltage.PNG

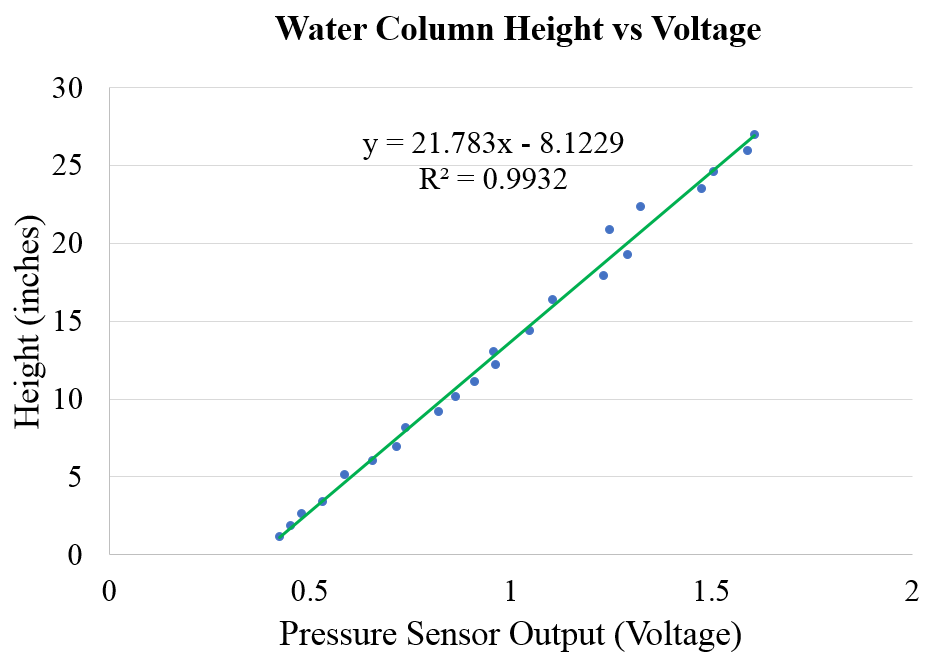
Tests_Data/Water_Height_vs_Voltage.PNG
